FaddliLWibowo/Seeeduino_Stalker_V3_1/images/IMG_1735.JPG

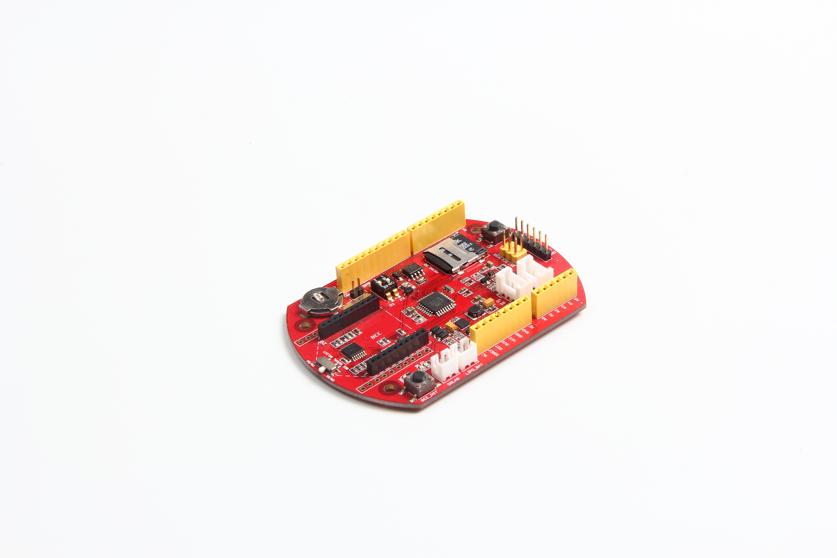
images/IMG_1735.JPG
