FaddliLWibowo/Seeeduino_Stalker_V3_1/images/pinout.png

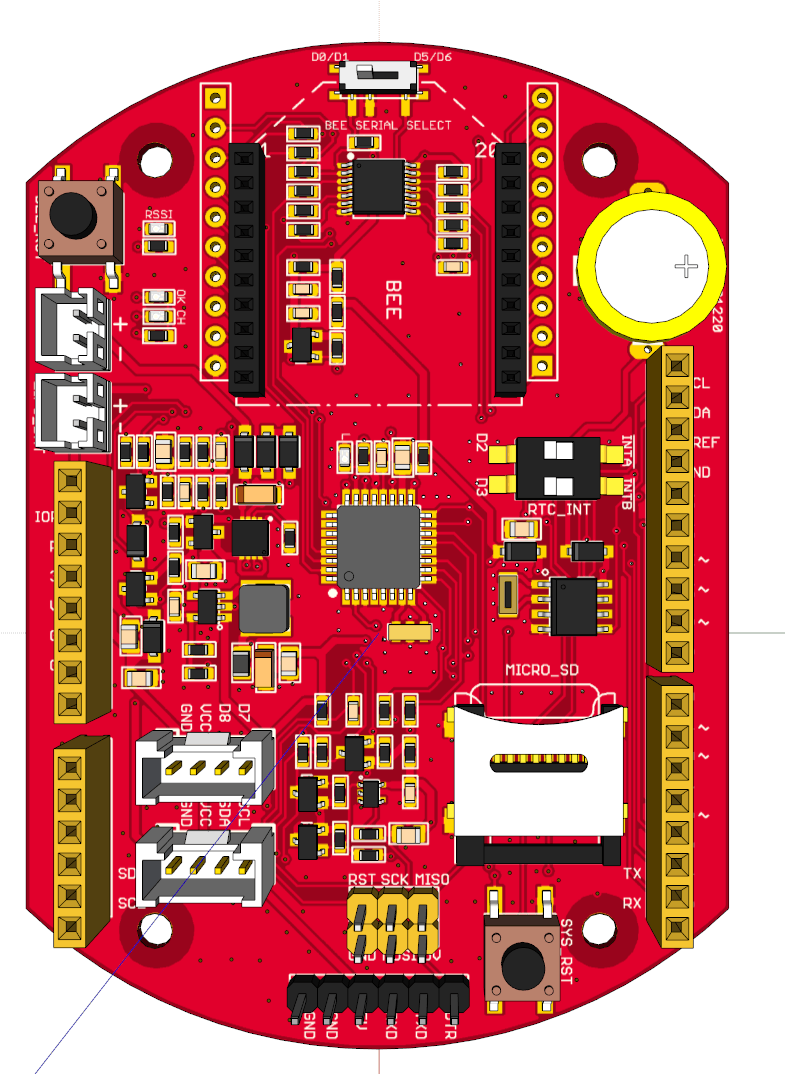
images/pinout.png
