FaddliLWibowo/Seeeduino_Stalker_V3_1/images/yhdIllxDC8wkSMidWgGLepPU.jpg

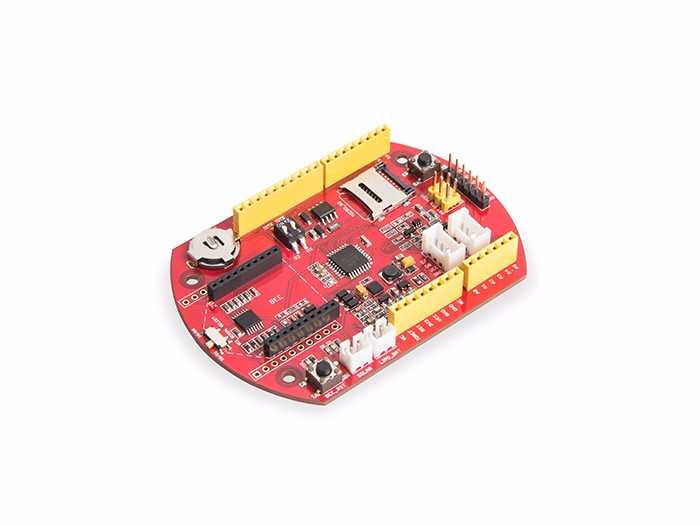
images/yhdIllxDC8wkSMidWgGLepPU.jpg
