FaddliLWibowo/Seeeduino_Stalker_V3_1/images/正面_无排针.png

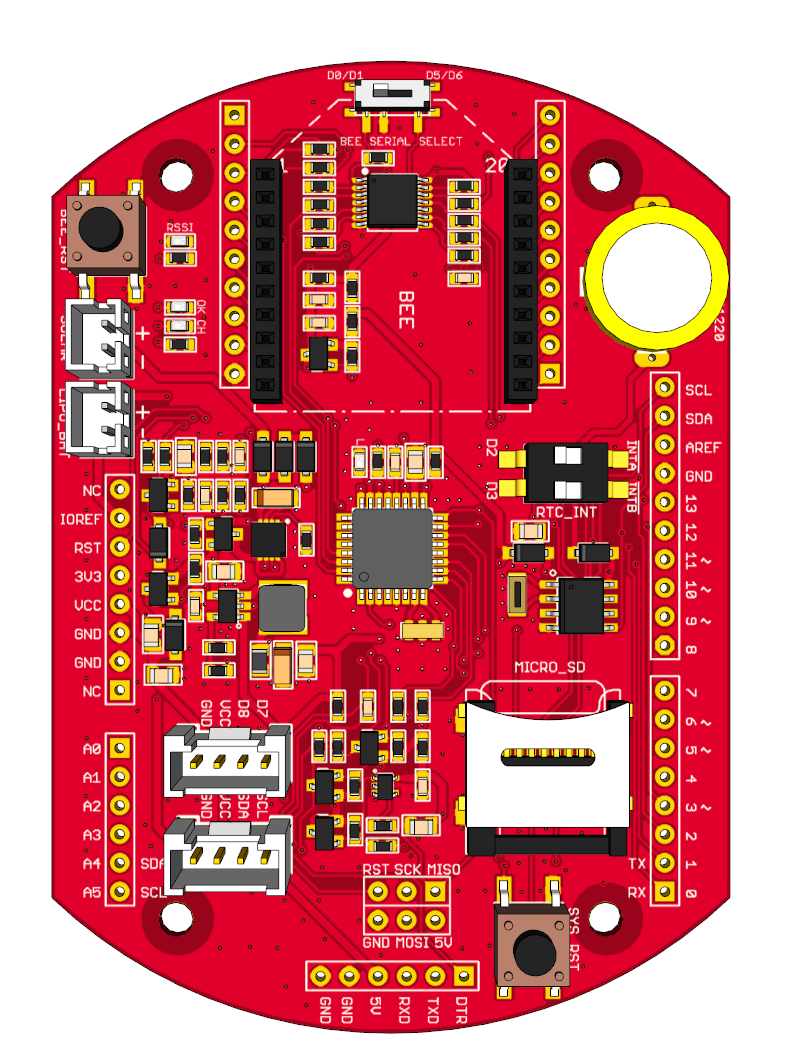
images/正面_无排针.png
