FaddliLWibowo/Seeeduino_Stalker_V3_1/images/正面图.png

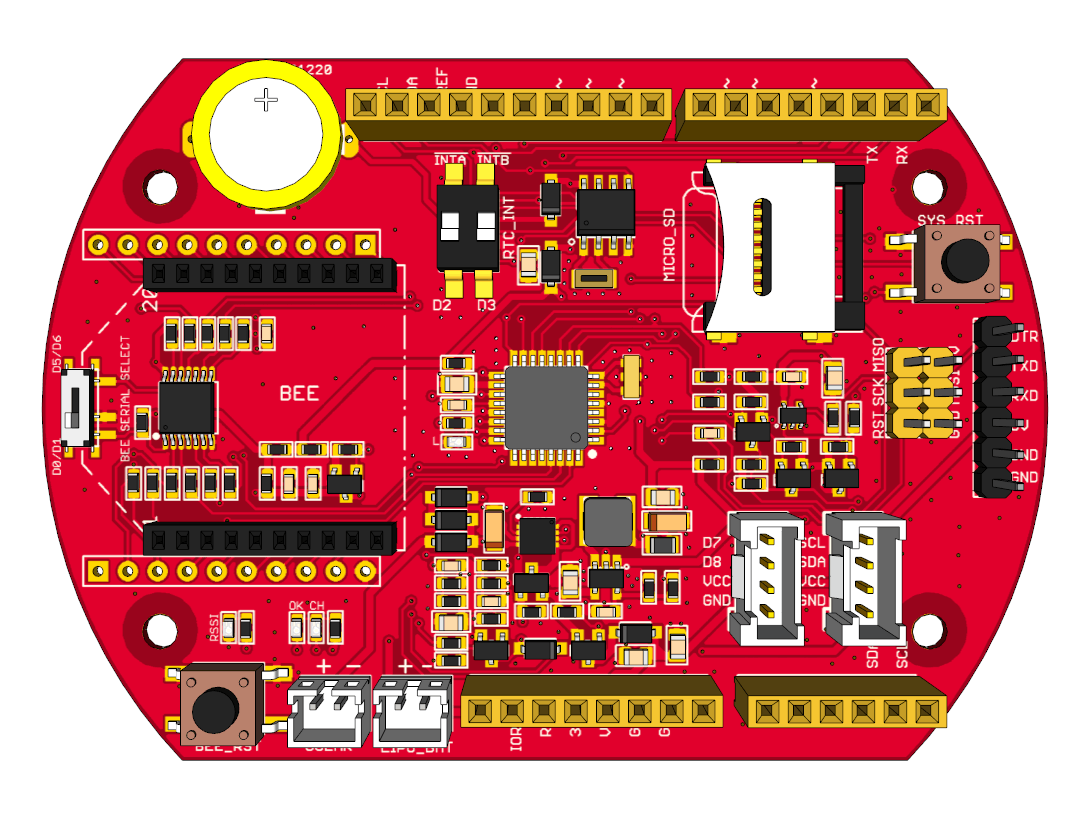
images/正面图.png
