FaddliLWibowo/Seeeduino_Stalker_V3_1/images/背面图.png

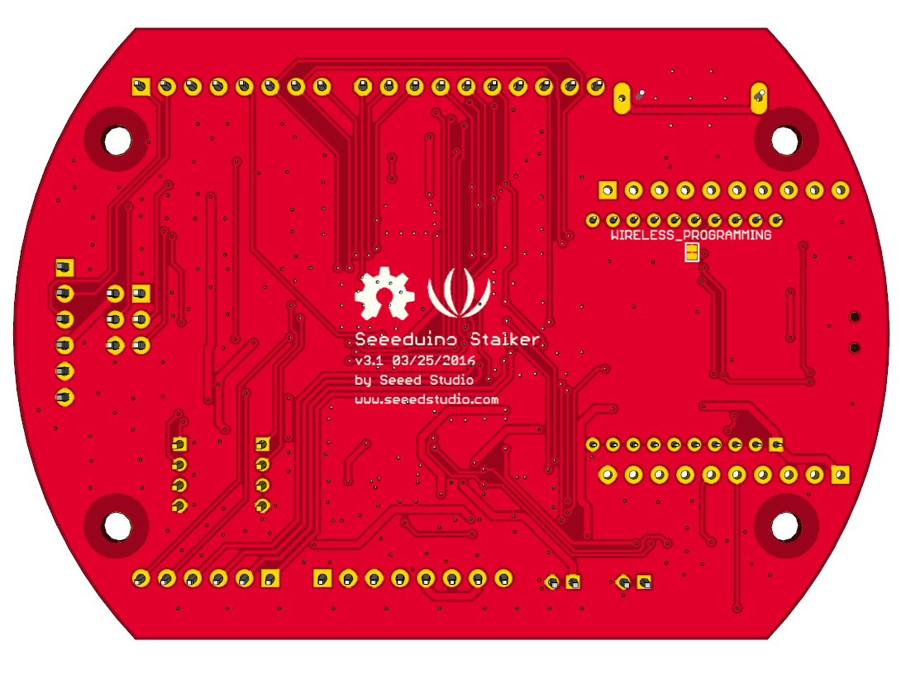
images/背面图.png
