FaddliLWibowo/Seeeduino_Stalker_V3_1/images/背面无排针.png

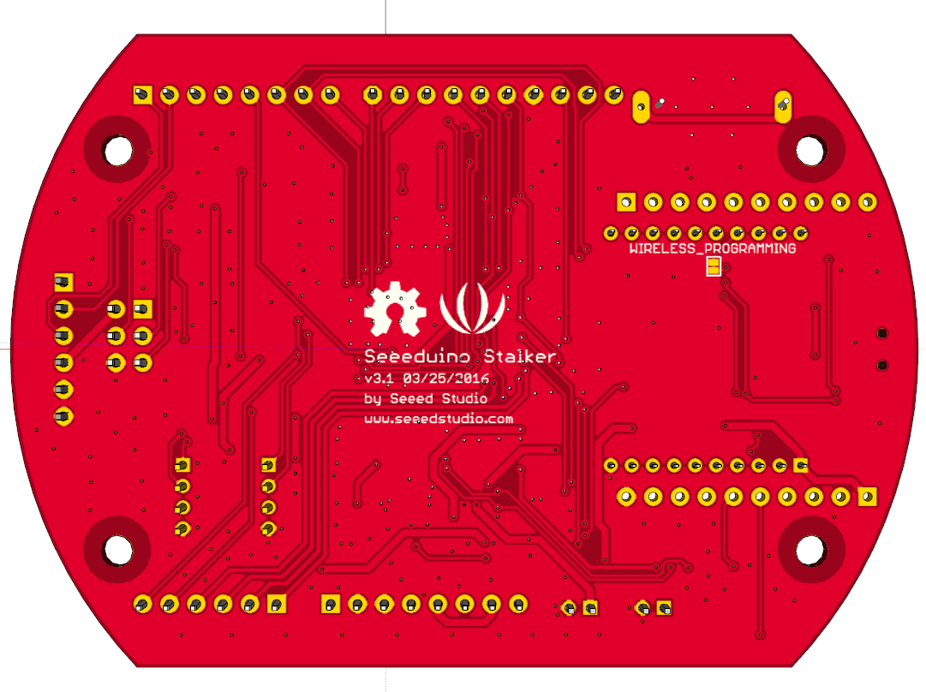
images/背面无排针.png
