FaddliLWibowo/Seeeduino_Stalker_V3_1/resources/Seeeduino Stalker v3.1.pdf

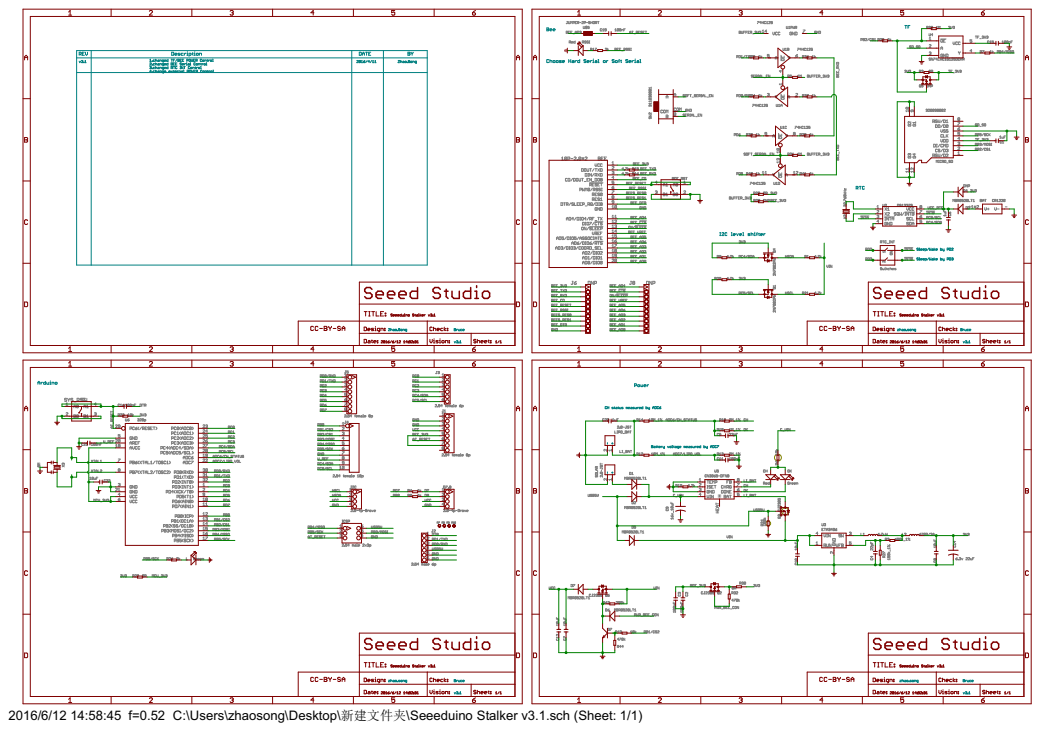
[picture p29: page 1]

2016/6/12 14:58:45 f=0.52 C:\Users\zhaosong\Desktop\新建文件夹\Seeeduino Stalker v3.1.sch (Sheet: 1/1)
