FaddliLWibowo/Seeeduino_Stalker_V3_1/resources/202000956_Seeeduino Stalker v3.1/Seeeduino Stalker v3.1.brd

## EAGLE design resources/202000956_Seeeduino Stalker v3.1/Seeeduino Stalker v3.1.brd (2016-07-29, last stored version)

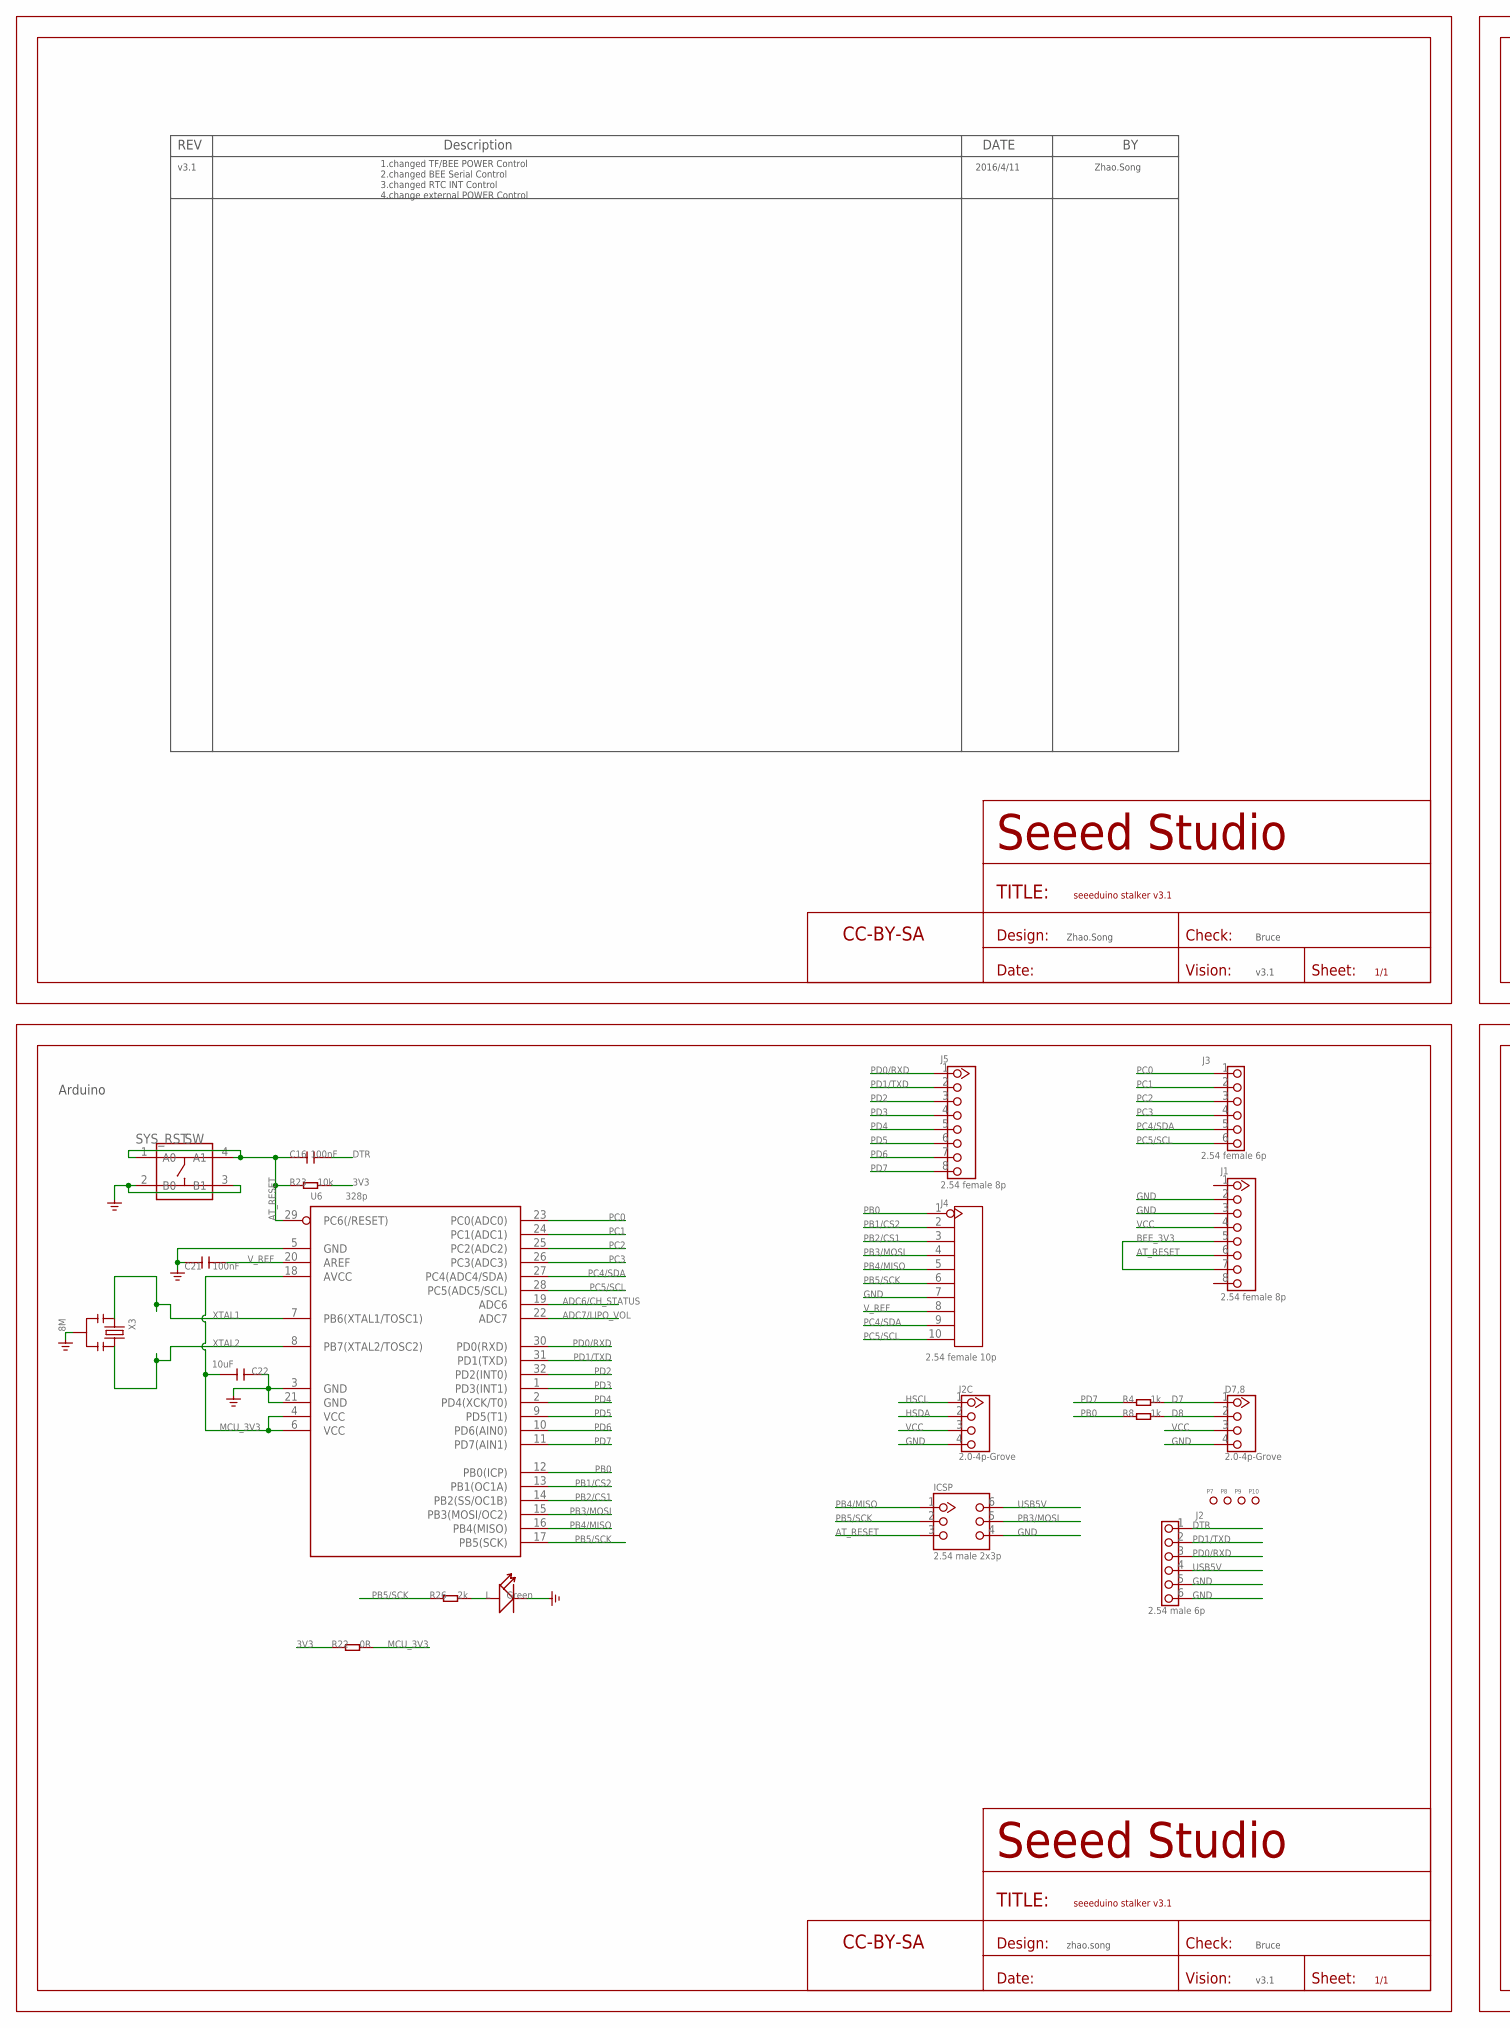
[picture p30: schematic Seeeduino Stalker v3.1.sch, part in row 1, column 1]

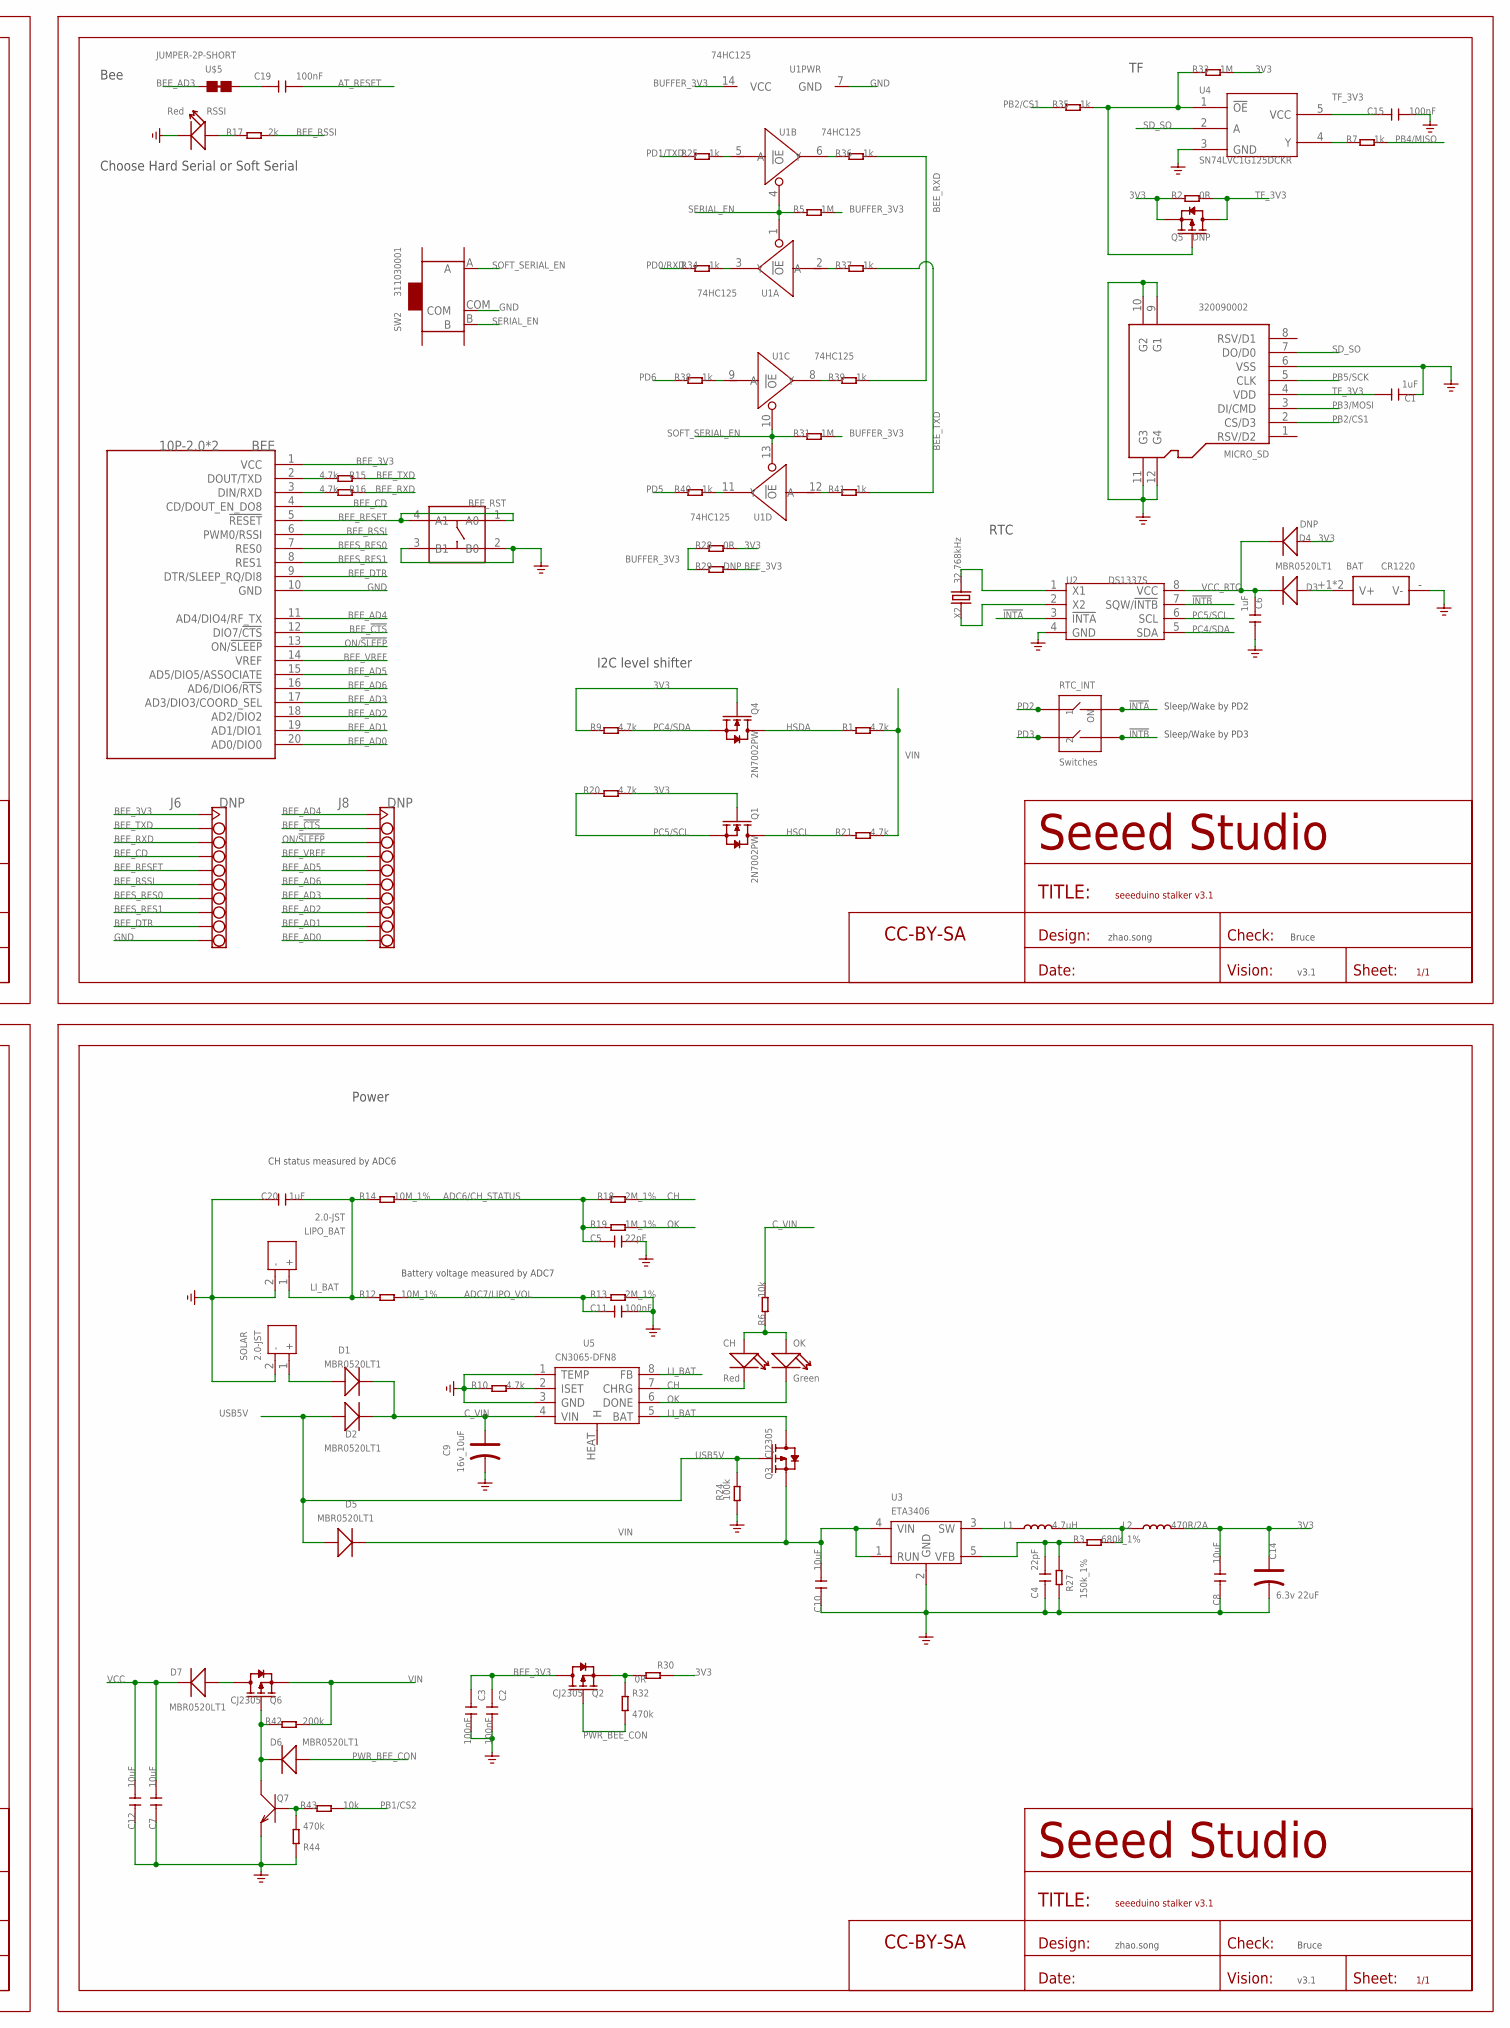
[picture p31: schematic Seeeduino Stalker v3.1.sch, part in row 1, column 2]

Parts:
BAT: CR1220; BAT2P-13.5-CR1220
BEE: 10P-2.0*2; BEE
BEE_RST: SW; 4P-SMD-6.2X6.2X4H
C1, C6, C20: 1uF; C0805
C2, C3, C11, C15, C16, C19, C21: 100nF; C0603
C4, C5: 22pF; C0603
C7, C8, C10, C12, C22: 10uF; C0805
C9: 16v_10uF; AVX-A
C14: 6.3v 22uF; AVX-A
CH: Red; D0603
D1, D2, D3, D5, D6, D7: MBR0520LT1; SOD123-2.7X1.6
D4: DNP; SOD123-2.7X1.6
D7,8: 2.0-4p-Grove; 4P-2.0
I2C: 2.0-4p-Grove; 4P-2.0
ICSP: 2.54 male 2x3p; 2X3P-2.54-LEADED
J1, J5: 2.54 female 8p; 8P-2.54-LEADED
J2: 2.54 male 6p; 6P-2.54-LEADED
J3: 2.54 female 6p; 6P-2.54-LEADED
J4: 2.54 female 10p; 10P-2.54
J6, J8: DNP; HEADER_1X10
L: Green; D0603
L1: 4.7uH; L0420
L2: 470R/2A; L0805
LIPO_BAT: 2.0-JST; JST-2.0
MICRO_SD: 320090002; MICRO-SD8+4P-SMD-14.5X13.6X1.8MM
OK: Green; D0603
P7, P8, P9, P10: DNP; ROUND-MARK-1.0
Q1, Q4: 2N7002PW; SOT23
Q2, Q3, Q6: CJ2305; SOT23
Q5: DNP; SOT23
Q7: TRANSISTOR-NPN-SOT23; SOT-23
R1, R9, R10, R15, R16, R20, R21: 4.7k; 0603@1
R2, R22, R28, R30: 0R; 0603@1
R3: 680k_1%; 0603@1
R4, R7, R8, R25, R34, R35, R36, R37, R38, R39, R40, R41: 1k; 0603@1
R5, R31, R33: 1M; 0603@1
R6, R23, R43: 10k; 0603@1
R12, R14: 10M_1%; 0603@1
R13, R18: 2M_1%; 0603@1
R17, R26: 2k; 0603@1
R19: 1M_1%; 0603@1
R24: 100k; 0603@1
R27: 150k_1%; 0603@1
R29: DNP; 0603@1
R32, R44: 470k; 0603@1
R42: 200k; 0603@1
RSSI: Red; D0603
RTC_INT: Switches; SW4-SMD-2.54-5.08X6.8X3.3MM
SOLAR: 2.0-JST; JST-2.0
SW2: 311030001; SW7-SMD-L6.7X2.7X3.2MM
SYS_RST: SW; 4P-SMD-6.2X6.2X4H
U1: 74HC125; TSSOP14-0.65-5X4.4MM
U2: DS1337S; SOP8
U3: ETA3406; SOT23-5
U4: SN74LVC1G125DCKR; SOT353
U5: CN3065-DFN8; DFN8
U6: 328p; TQFP32-0.8-7X7MM
U$2, U$11, U$12, U$27: DNP; SEEEDSTUDIO-PCB-FRAME
U$5: JUMPER-2P-SHORT; 2P-SMD-SHORT
X2: 32.768kHz; 2P-SMD-3.2X1.5
X3: 8M; RESONATOR3-SMD-3.6X1.3X0.8MM

Connections:
3V3: C8.2, C14.+, D4.1 (+), L2.2, Q1.1 (G), Q4.1 (G), Q5.2 (S), R2.1, R9.1, R20.2, R22.1, R23.2, R28.2, R30.1, R33.2
!INTA: RTC_INT.4, U2.3 (!INTA)
!INTB: RTC_INT.3, U2.7 (SQW/!INTB)
ADC6/CH_STATUS: C5.1, R14.2, R18.1, R19.1, U6.19 (ADC6)
ADC7/LIPO_VOL: C11.1, R12.2, R13.1, U6.22 (ADC7)
AT_RESET: C16.1, C19.2, ICSP.3, J1.6, R23.1, SYS_RST.1 (A0), SYS_RST.4 (A1), U6.29 (PC6(/RESET))
BEES_RES0: BEE.7 (RES0), J6.7
BEES_RES1: BEE.8 (RES1), J6.8
BEE_3V3: BEE.1 (VCC), C2.1, C3.1, J1.5, J1.7, J6.1, Q2.3 (D), R29.2
BEE_!CTS: BEE.12 (DIO7/!CTS), J8.2
BEE_AD0: BEE.20 (AD0/DIO0), J8.10
BEE_AD1: BEE.19 (AD1/DIO1), J8.9
BEE_AD2: BEE.18 (AD2/DIO2), J8.8
BEE_AD3: BEE.17 (AD3/DIO3/COORD_SEL), J8.7, U$5.1
BEE_AD4: BEE.11 (AD4/DIO4/RF_TX), J8.1
BEE_AD5: BEE.15 (AD5/DIO5/ASSOCIATE), J8.5
BEE_AD6: BEE.16 (AD6/DIO6/!RTS), J8.6
BEE_CD: BEE.4 (CD/DOUT_EN_DO8), J6.4
BEE_DTR: BEE.9 (DTR/SLEEP_RQ/DI8), J6.9
BEE_RESET: BEE.5 (!RESET), BEE_RST.1 (A0), BEE_RST.4 (A1), J6.5
BEE_RSSI: BEE.6 (PWM0/RSSI), J6.6, R17.2
BEE_RXD: J6.3, R16.1, R36.2, R39.2
BEE_TXD: J6.2, R15.1, R37.2, R41.2
BEE_VREF: BEE.14 (VREF), J8.4
BUFFER_3V3: R5.2, R28.1, R29.1, R31.2, U1.14 (VCC)
CH: CH.-, R18.2, U5.7 (CHRG)
C_VIN: C9.+, D1.2 (-), D2.2 (-), R6.2, U5.4 (VIN)
D7: D7,8.1, R4.2
D8: D7,8.2, R8.2
DTR: C16.2, J2.1
GND: BAT.- (V-), BEE.10 (GND), BEE_RST.2 (B0), BEE_RST.3 (B1), C1.1, C2.2, C3.2, C4.1, C5.2, C6.2, C7.1, C8.1, C9.-, C10.1, C11.2, C12.1, C14.-, C15.2, C20.1, C21.1, C22.1, D7,8.4, I2C.4, ICSP.4, J1.2, J1.3, J2.5, J2.6, J4.7, J6.10, L.-, LIPO_BAT.2, MICRO_SD.6 (VSS), MICRO_SD.9 (G1), MICRO_SD.10 (G2), MICRO_SD.11 (G3), MICRO_SD.12 (G4), Q7.2 (E), R10.1, R13.2, R24.1, R27.1, R44.2, RSSI.-, SOLAR.2, SW2.COM, SYS_RST.2 (B0), SYS_RST.3 (B1), U1.7 (GND), U2.4 (GND), U3.2 (GND), U4.3 (GND), U5.1 (TEMP), U5.3 (GND), U6.3 (GND), U6.5 (GND), U6.21 (GND), X3.2
HSCL: I2C.1, Q1.3 (D), R21.1
HSDA: I2C.2, Q4.3 (D), R1.1
LI_BAT: C20.2, LIPO_BAT.1, Q3.3 (D), R12.1, R14.1, U5.5 (BAT), U5.8 (FB)
MCU_3V3: C22.2, R22.2, U6.4 (VCC), U6.6 (VCC), U6.18 (AVCC)
unnamed: C4.2, R3.1, R27.2, U3.5 (VFB)
unnamed: C19.1, U$5.2
unnamed: D1.1 (+), SOLAR.1
unnamed: BAT.+1 (V+), BAT.+2 (V+), D3.1 (+)
unnamed: R10.2, U5.2 (ISET)
unnamed: R17.1, RSSI.+
unnamed: U2.1 (X1), X2.2
unnamed: CH.+, OK.+, R6.1
unnamed: U2.2 (X2), X2.1
unnamed: R34.2, U1.3 (Y)
unnamed: D7.1 (+), Q6.3 (D)
unnamed: R38.2, U1.9 (A)
unnamed: Q7.1 (B), R43.2, R44.1
unnamed: L1.2, L2.1, R3.2
unnamed: L1.1, U3.3 (SW)
unnamed: R7.1, U4.4 (Y)
unnamed: R40.2, U1.11 (Y)
unnamed: L.+, R26.2
unnamed: R36.1, U1.6 (Y)
unnamed: BEE.2 (DOUT/TXD), R15.2
unnamed: BEE.3 (DIN/RXD), R16.2
unnamed: R37.1, U1.2 (A)
unnamed: R39.1, U1.8 (Y)
unnamed: R41.1, U1.12 (A)
unnamed: R25.2, U1.5 (A)
unnamed: Q2.2 (S), R30.2, R32.1
unnamed: Q5.1 (G), R33.1, R35.2, U4.1 (!OE!)
unnamed: D6.2 (-), Q6.1 (G), Q7.3 (C), R42.2
OK: OK.-, R19.2, U5.6 (DONE)
ON/!SLEEP: BEE.13 (ON/!SLEEP), J8.3
PB0: J4.1, R8.1, U6.12 (PB0(ICP))
PB1/CS2: J4.2, R43.1, U6.13 (PB1(OC1A))
PB2/CS1: J4.3, MICRO_SD.2 (CS/D3), R35.1, U6.14 (PB2(SS/OC1B))
PB3/MOSI: ICSP.5, J4.4, MICRO_SD.3 (DI/CMD), U6.15 (PB3(MOSI/OC2))
PB4/MISO: ICSP.1, J4.5, R7.2, U6.16 (PB4(MISO))
PB5/SCK: ICSP.2, J4.6, MICRO_SD.5 (CLK), R26.1, U6.17 (PB5(SCK))
PC0: J3.1, U6.23 (PC0(ADC0))
PC1: J3.2, U6.24 (PC1(ADC1))
PC2: J3.3, U6.25 (PC2(ADC2))
PC3: J3.4, U6.26 (PC3(ADC3))
PC4/SDA: J3.5, J4.9, Q4.2 (S), R9.2, U2.5 (SDA), U6.27 (PC4(ADC4/SDA))
PC5/SCL: J3.6, J4.10, Q1.2 (S), R20.1, U2.6 (SCL), U6.28 (PC5(ADC5/SCL))
PD0/RXD: J2.3, J5.1, R34.1, U6.30 (PD0(RXD))
PD1/TXD: J2.2, J5.2, R25.1, U6.31 (PD1(TXD))
PD2: J5.3, RTC_INT.1, U6.32 (PD2(INT0))
PD3: J5.4, RTC_INT.2, U6.1 (PD3(INT1))
PD4: J5.5, U6.2 (PD4(XCK/T0))
PD5: J5.6, R40.1, U6.9 (PD5(T1))
PD6: J5.7, R38.1, U6.10 (PD6(AIN0))
PD7: J5.8, R4.1, U6.11 (PD7(AIN1))
PWR_BEE_CON: D6.1 (+), Q2.1 (G), R32.2
SD_SO: MICRO_SD.7 (DO/D0), U4.2 (A)
SERIAL_EN: R5.1, SW2.B, U1.1 (!OE), U1.4 (!OE)
SOFT_SERIAL_EN: R31.1, SW2.A, U1.10 (!OE), U1.13 (!OE)
TF_3V3: C1.2, C15.1, MICRO_SD.4 (VDD), Q5.3 (D), R2.2, U4.5 (VCC)
USB5V: D2.1 (+), D5.1 (+), ICSP.6, J2.4, Q3.1 (G), R24.2
VCC: C7.2, C12.2, D7.2 (-), D7,8.3, I2C.3, J1.4
VCC_RTC: C6.1, D3.2 (-), D4.2 (-), U2.8 (VCC)
VIN: C10.2, D5.2 (-), Q3.2 (S), Q6.2 (S), R1.2, R21.2, R42.1, U3.1 (RUN), U3.4 (VIN)
V_REF: C21.2, J4.8, U6.20 (AREF)
XTAL1: U6.7 (PB6(XTAL1/TOSC1)), X3.1
XTAL2: U6.8 (PB7(XTAL2/TOSC2)), X3.3

Notes on the sheet:
Power
Arduino
Bee
Battery voltage measured by ADC7
RTC
Sleep/Wake by PD2
Sleep/Wake by PD3
CH status measured by ADC6
Choose Hard Serial or Soft Serial
zhao.song
Bruce
v3.1
2016/4/11
Zhao.Song
1.changed TF/BEE POWER Control 2.changed BEE Serial Control 3.changed RTC INT Control 4.change external POWER Control
I2C level shifter

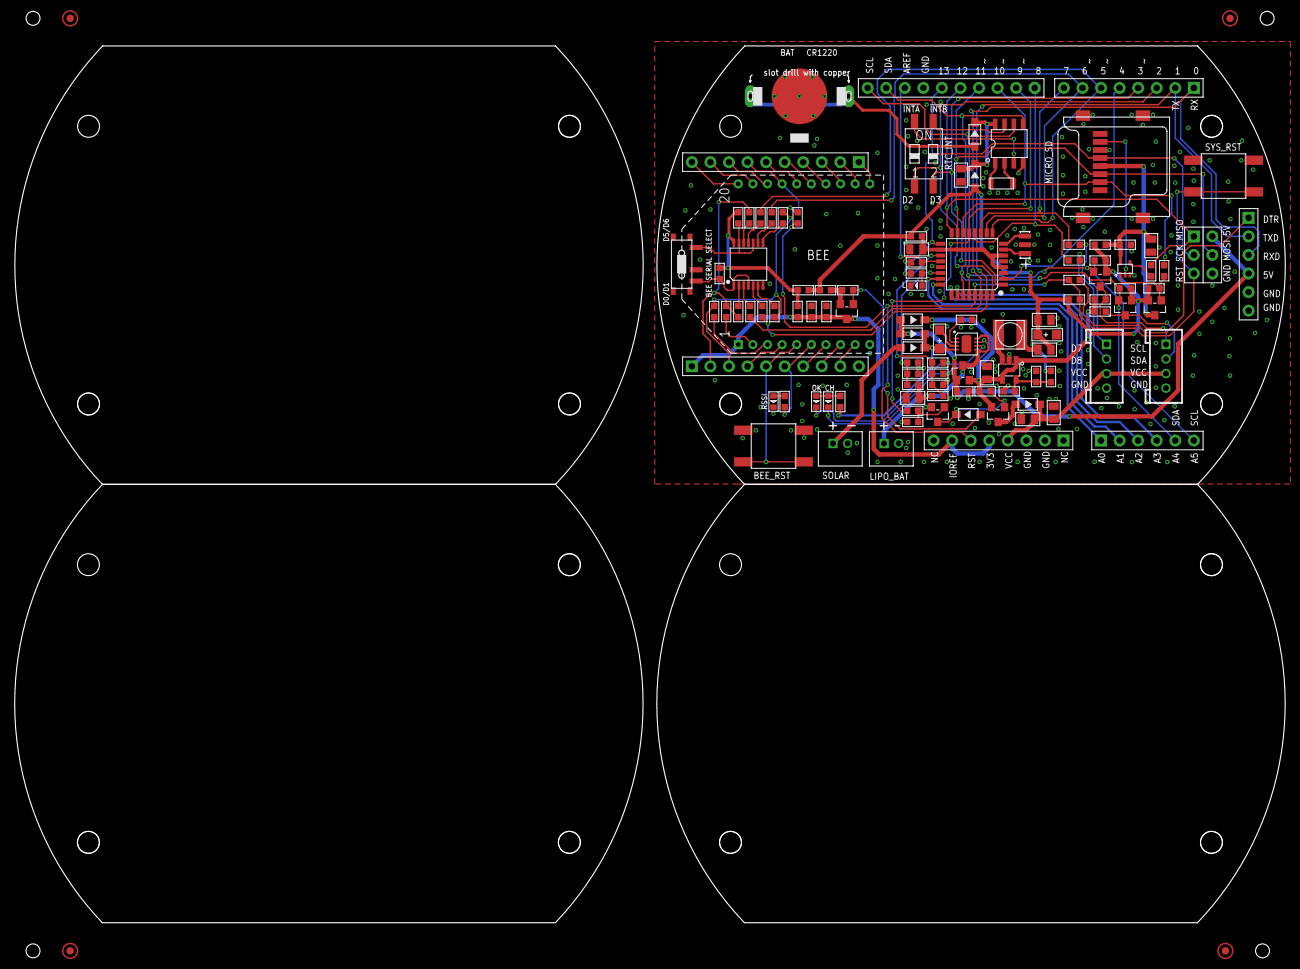
[picture p32: board Seeeduino Stalker v3.1.brd from above]

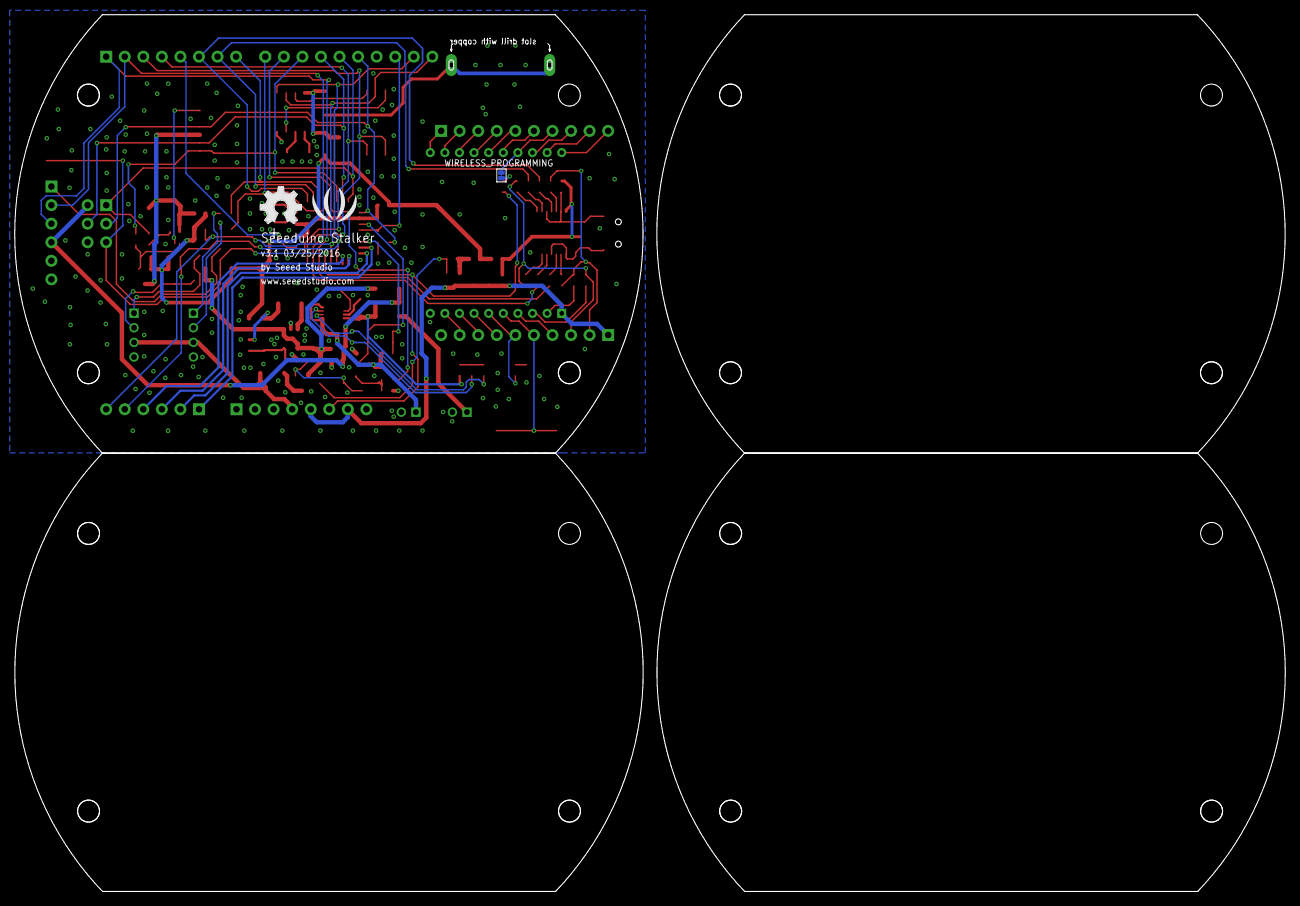
[picture p33: board Seeeduino Stalker v3.1.brd from below]

Board: 2 copper layers, 173.9 x 120.0 mm, 120 parts (3 on the bottom side), 97 nets.

Other parts of the board:
U$23: OSHW_FILLX200_NOTEXT
U$24: LOGO_SILK
